LenShustek/PhantomVision/internals_annoted_02.jpg

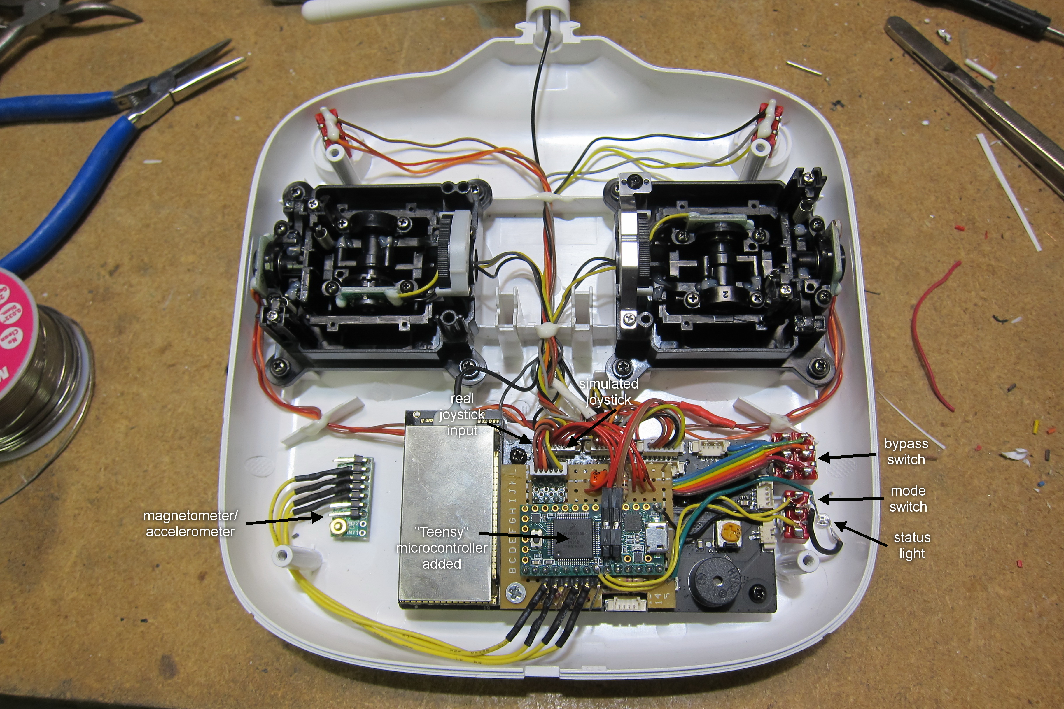
internals_annoted_02.jpg
