LenShustek/PhantomVision/schematic_03.pdf

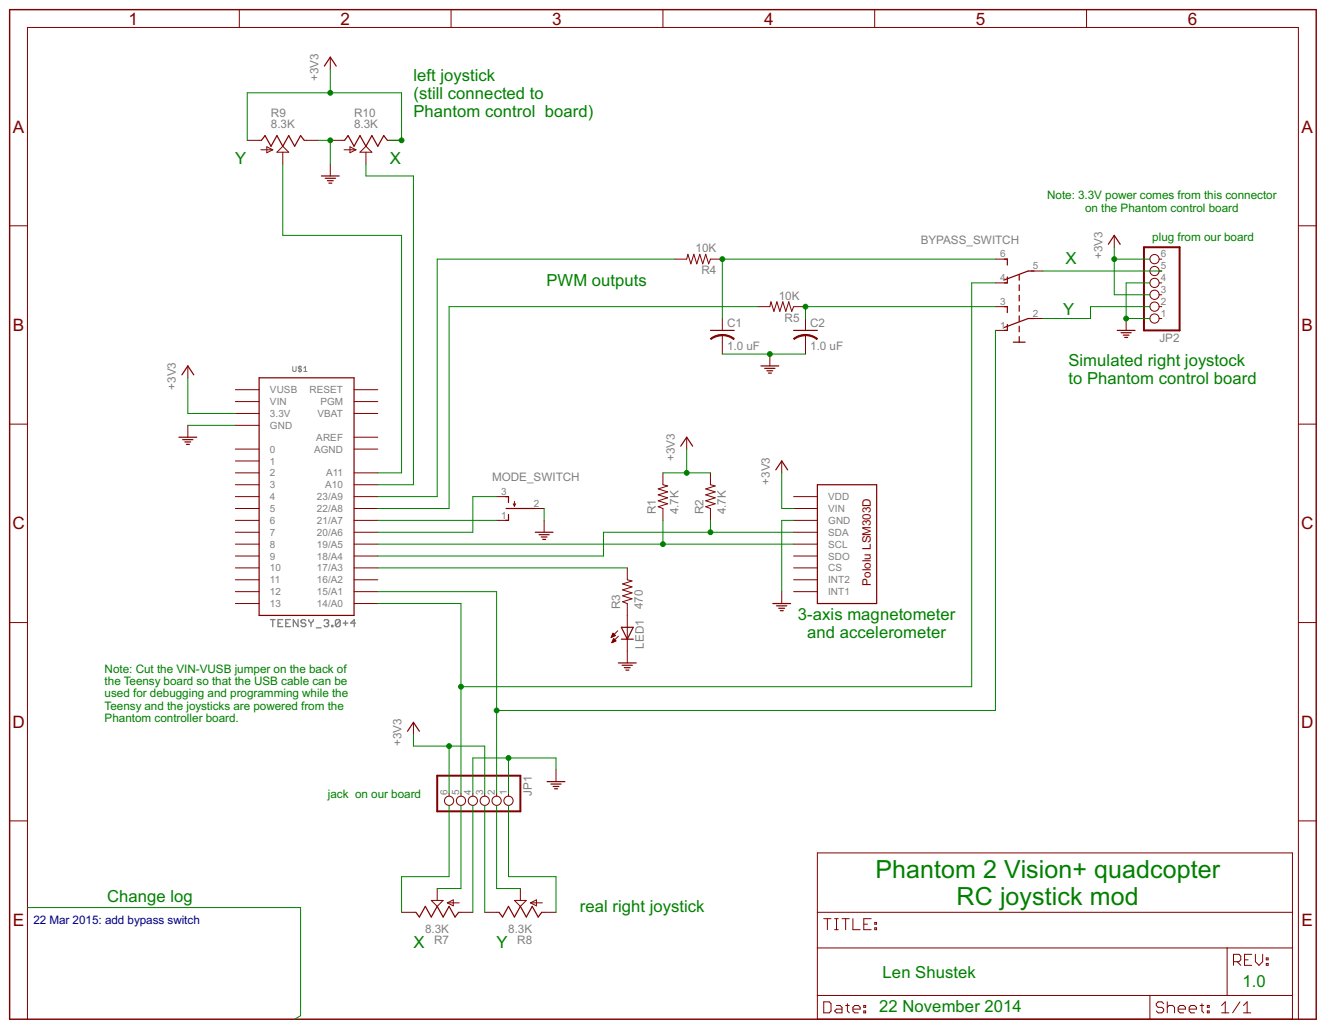
[picture p2: page 1]

Note: 3.3V power comes from this connector on the Phantom control board

plug from our board

Simulated right joystock
to Phantom control board

Note: Cut the VIN-VUSB jumper on the back of
the Teensy board so that the USB cable can be
used for debugging and programming while the Teensy and the joysticks are powered from the Phantom controller board.

jack on our board

22 Mar 2015: add bypass switch
