LenShustek/PhantomVision/(threads)

Thread 1 (2014-11-24):

Remote controller mods

LenShustek, 2014-11-24:
This is what I added to my Phantom 2 Vision+ remote controller to allow a new "pilot-centric" mode of flying.  See http://forum.dji.com/forum.php?mod=viewthread&tid=2287.

Attached are a photo of the mods, and an image of the schematic.

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

LenShustek, 2015-03-31:
added images to the source directory

Closed 2015-03-31.
